chipmc/Particle-Boron-Carrier-v1.0/README.md

View this project on [CADLAB.io](https://cadlab.io/project/1655).

# Particle-Boron-Carrier

This carrier is to support the use of the Boron in outdoor environments.
