chipmc/Particle-Boron-Carrier-v1.0/Carrier Board.csv

Part | Value | Device | Package | Description | HOUSEPART | MANUFACTURER_PART_NUMBER | MFG | MPN | OC_FARNELL | OC_NEWARK | PACKAGE | POPULATE | PROD_ID | SF_ID | SUPPLIER | TOLERANCE | URL | VALUE | VENDOR | VOLTAGE
BORON/ARGON/XENON | PARTICLE-DEVICES-BORON | PARTICLE-DEVICES-BORON | PARTICLE-DEVICES_BORON | Particle Boron Device for Carrier Board Placement
C1 | 0.1uF | CAP0805 | 0805@1 | Capacitor
C2 | 1uF | CAP0805 | 0805@1 | Capacitor
C3 | 0.1uF | CAP0805 | 0805@1 | Capacitor
C4 | 0.1uF | CAP0805 | 0805@1 | Capacitor
C5 | 1uF | CAP0805 | 0805@1 | Capacitor
C8 | 470uF | CAPACITOR_P_10MM | CP10MM | Library: MF_Passives |  |  |  |  |  |  |  | 1
D1 | MF-DIO-SOD123-BAT42 | DIODES_BAT42_SOD-123 | SOD-123 | Library: MF_Discrete_Semiconductor | YES |  |  | MF-DIO-SOD123-BAT42 |  |  |  | 1 |  |  |  |  | https://factory.macrofab.com/part/MF-DIO-SOD123-BAT42 | MF-DIO-SOD123-BAT42
D2 | MF-DIO-SOD123-BAT42 | DIODES_BAT42_SOD-123 | SOD-123 | Library: MF_Discrete_Semiconductor | YES |  |  | MF-DIO-SOD123-BAT42 |  |  |  | 1 |  |  |  |  | https://factory.macrofab.com/part/MF-DIO-SOD123-BAT42 | MF-DIO-SOD123-BAT42
D3 | MF-DIO-SOD123-BAT42 | DIODES_BAT42_SOD-123 | SOD-123 | Library: MF_Discrete_Semiconductor | YES |  |  | MF-DIO-SOD123-BAT42 |  |  |  | 1 |  |  |  |  | https://factory.macrofab.com/part/MF-DIO-SOD123-BAT42 | MF-DIO-SOD123-BAT42
F1 | 1.5A - SLOW BLOW | PPTC_HALF-AMP | 1206 | Resettable Fuse PPTC |  |  |  |  |  |  |  |  | RES-08585 |  |  |  |  | 6V/0.5A
F2 | 500mA - FAST BLOW | PPTC_HALF-AMP | 1206 | Resettable Fuse PPTC |  |  |  |  |  |  |  |  | RES-08585 |  |  |  |  | 6V/0.5A
F3 | 500mA - FAST BLOW | PPTC_HALF-AMP | 1206 | Resettable Fuse PPTC |  |  |  |  |  |  |  |  | RES-08585 |  |  |  |  | 6V/0.5A
FD1 | FIDUCIALUFIDUCIAL | FIDUCIALUFIDUCIAL | FIDUCIAL-MICRO | Fiducial Alignment Points
FD2 | FIDUCIALUFIDUCIAL | FIDUCIALUFIDUCIAL | FIDUCIAL-MICRO | Fiducial Alignment Points
FRAME1 | FRAME-LETTER | FRAME-LETTER | CREATIVE_COMMONS | Schematic Frame - Letter
FRAME2 | FRAME-LETTER | FRAME-LETTER | CREATIVE_COMMONS | Schematic Frame - Letter
FRAME3 | FRAME-LETTER | FRAME-LETTER | CREATIVE_COMMONS | Schematic Frame - Letter
G1 | D5V0L4B5TS | D5V0L4B5TS | SOT-23-5 | 4 CHANNEL LOW CAPACITANCE BI-DIRECTIONAL TVS ARRAY
J1 | H4P-SMD-2.0 | GROVE-CONNECTOR-SMD(4+2P-2.0) | HW4-SMD-2.0 | 320110030 |  |  |  |  |  |  |  |  |  |  |  |  |  | H4P-SMD-2.0
J2 | H4P-SMD-2.0 | GROVE-CONNECTOR-SMD(4+2P-2.0) | HW4-SMD-2.0 | 320110030 |  |  |  |  |  |  |  |  |  |  |  |  |  | H4P-SMD-2.0
J3 |  | CONN_02 | 1X02 | Multi connection point. Often used as Generic Header-pin footprint for 0.1 inch spaced/style header connections
J4 | S2B-PH-SM4-TB(LF)(SN) | JST_2MM_MALE | JST-2-SMD | JST 2MM MALE RA CONNECTOR |  |  | S2B-PH-SM4-TB(LF)(SN) |  |  |  |  |  | CONN-11443 | PRT-08612
J5 | S2B-PH-SM4-TB(LF)(SN) | JST_2MM_MALE | JST-2-SMD | JST 2MM MALE RA CONNECTOR |  |  | S2B-PH-SM4-TB(LF)(SN) |  |  |  |  |  | CONN-11443 | PRT-08612
JP1 |  | M06LOCK | 1X06_LOCK | Header 6
JP2 |  | M06LOCK | 1X06_LOCK | Header 6
JP3 | STAND-OFF | STAND-OFF | STAND-OFF | Stand Off
JP4 | STAND-OFF | STAND-OFF | STAND-OFF | Stand Off
JP5 | STAND-OFF | STAND-OFF | STAND-OFF | Stand Off
JP6 | STAND-OFF | STAND-OFF | STAND-OFF | Stand Off
JP7 | JUMPER-SMT_3_1-NC_TRACE_SILK | JUMPER-SMT_3_1-NC_TRACE_SILK | SMT-JUMPER_3_1-NC_TRACE_SILK | Normally closed trace jumper (1 of 2 connections)
JP9 | JUMPER-SMT_2_NC_PASTE_SILK | JUMPER-SMT_2_NC_PASTE_SILK | SMT-JUMPER_2_NC_PASTE_SILK | Normally closed solder jumper
Q1 | MMBT2222A | TRANS_NPN-MMBT2222AL | SOT23-3 | NPN transistor |  |  |  |  |  |  |  |  | TRANS-08049 |  |  |  |  | 600mA/40V
R1 | 270k | RESISTOR0805-RES | 0805 | Resistor
R2 | 270k | RESISTOR0805-RES | 0805 | Resistor
R3 | 100k | RESISTOR0805-RES | 0805 | Resistor
R4 | 100k | RESISTOR0805-RES | 0805 | Resistor
R5 | 10k | RESISTOR0805-RES | 0805 | Resistor
R6 | 4.7k | RESISTOR0805-RES | 0805 | Resistor
R7 | 4.7k | RESISTOR0805-RES | 0805 | Resistor
R10 | 10k | RESISTOR0805-RES | 0805 | Resistor
R11 | 100k | RESISTOR0805-RES | 0805 | Resistor
R12 | 100 | RESISTOR0805-RES | 0805 | Resistor
R13 | 100k | RESISTOR0805-RES | 0805 | Resistor
R14 | 100k | RESISTOR0805-RES | 0805 | Resistor
S2 | B3F-4000 | 40-XX-ROUND | B3F-40XX-ROUND | OMRON SWITCH
SW2 | MF-SW-TACT-6MM | TACT_6MM | TACT6MM | Library: MF_Switches | YES |  |  | MF-SW-TACT-6MM |  |  |  | 1 |  |  |  |  | https://factory.macrofab.com/part/MF-SW-TACT-6MM | MF-SW-TACT-6MM
U1 | TMP36GRTZ | TMP36GRTZ-REEL7 | RJ_5 |  |  | TMP36GRTZREEL7 |  |  |  |  |  |  |  |  |  |  |  |  | Analog Devices Inc
U2 | TPL5010 | TPL5010 | TSOT-23 | This is a TI Ultra-Low-Power External watchdog.
U3 | MB85RC64 | MB85RC128PNF-G-JNE1 | SOIC127P600X175-8N | Memory FRAM |  |  |  | MB85RC128PNF-G-JNE1 | 1831995 | 93R5161 | SO-8 |  |  |  | FUJITSU
U7 | NAND | 4093DT | MC14093B-TSSOP14 | Quad 2-input NAND schmitt trigger
V1 | VC080505C150DP | VARISTOR | 0805
V2 | VC080505C150DP | VARISTOR | 0805
V3 | VC080505C150DP | VARISTOR | 0805
