chipmc/Particle-Boron-Carrier-v1.0/Carrier Board.brd

## EAGLE design Carrier Board.brd (2019-04-28)

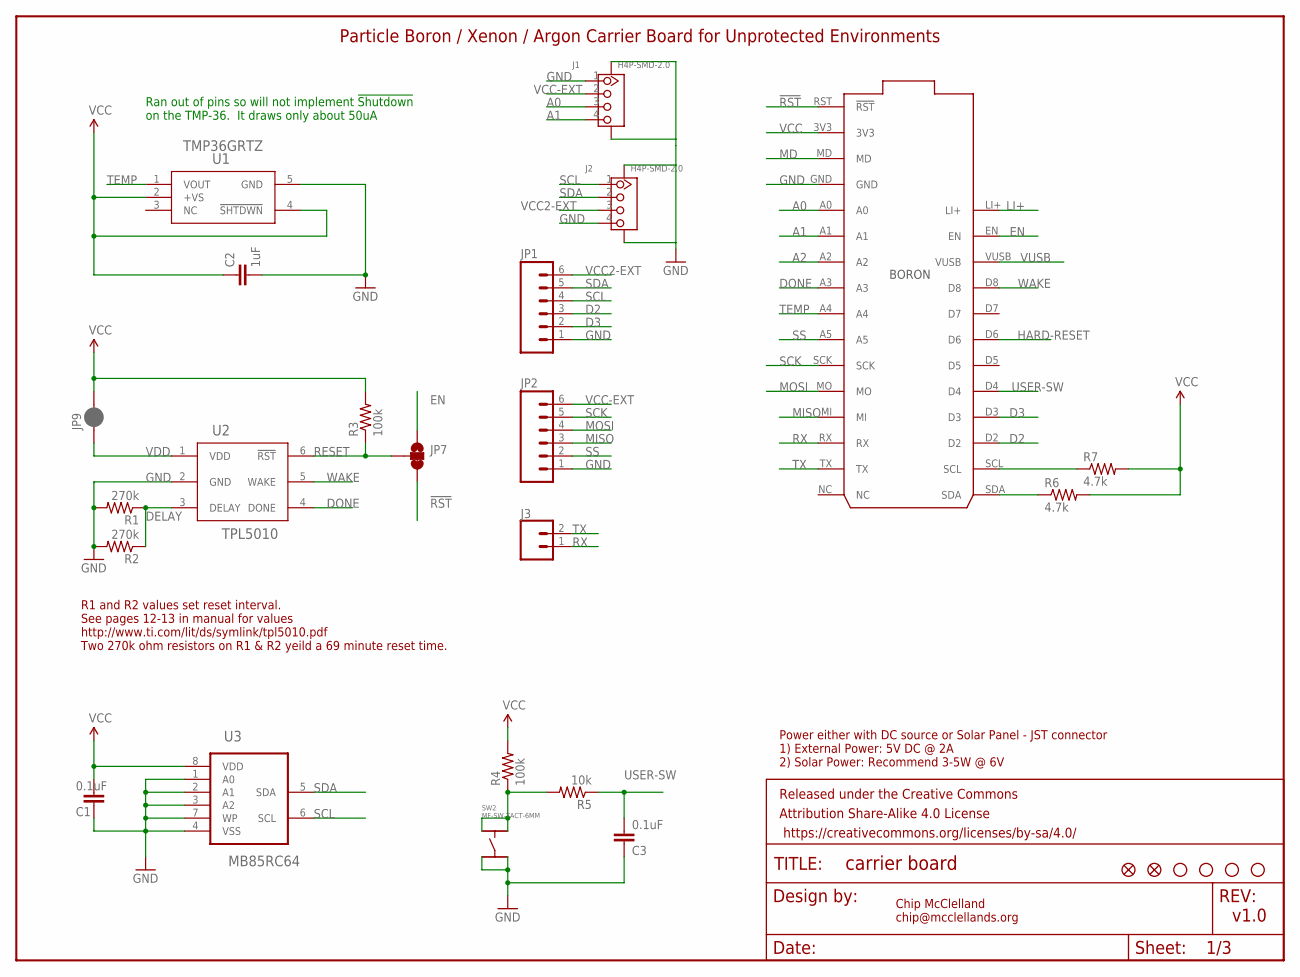
[picture p1: schematic Carrier Board.sch, sheet 1, Sensors]

Parts:
BORON/ARGON/XENON: PARTICLE-DEVICES-BORON; PARTICLE-DEVICES_BORON
C1, C3: 0.1uF; 0805@1
C2: 1uF; 0805@1
FD1, FD2: FIDUCIALUFIDUCIAL; FIDUCIAL-MICRO
FRAME1: FRAME-LETTER; CREATIVE_COMMONS
J1, J2: H4P-SMD-2.0; HW4-SMD-2.0
J3: CONN_02; 1X02
JP1, JP2: M06LOCK; 1X06_LOCK
JP3, JP4, JP5, JP6: STAND-OFF
JP7: JUMPER-SMT_3_1-NC_TRACE_SILK; SMT-JUMPER_3_1-NC_TRACE_SILK
JP9: JUMPER-SMT_2_NC_PASTE_SILK; SMT-JUMPER_2_NC_PASTE_SILK
R1, R2: 270k; 0805
R3, R4: 100k; 0805
R5: 10k; 0805
R6, R7: 4.7k; 0805
SW2: MF-SW-TACT-6MM; TACT6MM
U1: TMP36GRTZ; RJ_5
U2: TPL5010; TSOT-23
U3: MB85RC64; SOIC127P600X175-8N

Connections:
!RST: BORON/ARGON/XENON.RST (!RST), JP7.3
A0: BORON/ARGON/XENON.A0, J1.3
A1: BORON/ARGON/XENON.A1, J1.4
A2: BORON/ARGON/XENON.A2
D2: BORON/ARGON/XENON.D2, JP1.3; also elsewhere on the board
D3: BORON/ARGON/XENON.D3, JP1.2; also elsewhere on the board
DELAY: R1.1, R2.1, U2.3 (DELAY)
DONE: BORON/ARGON/XENON.A3, U2.4 (DONE)
EN: BORON/ARGON/XENON.EN, JP7.1; also elsewhere on the board
GND: BORON/ARGON/XENON.GND, C1.2, C2.2, C3.2, J1.1, J1.SS1, J1.SS2, J2.4, J2.SS1, J2.SS2, JP1.1, JP2.1, R1.2, R2.2, SW2.P$3, SW2.P$4, U1.5 (GND), U2.2 (GND), U3.1 (A0), U3.2 (A1), U3.3 (A2), U3.4 (VSS), U3.7 (WP); also elsewhere on the board
HARD-RESET: BORON/ARGON/XENON.D6; also elsewhere on the board
LI+: BORON/ARGON/XENON.LI+; also elsewhere on the board
MD: BORON/ARGON/XENON.MD
MISO: BORON/ARGON/XENON.MI, JP2.3
MOSI: BORON/ARGON/XENON.MO, JP2.4
unnamed: R4.1, R5.2, SW2.P$1, SW2.P$2
RESET: JP7.2, R3.1, U2.6 (!RST)
RX: BORON/ARGON/XENON.RX, J3.1
SCK: BORON/ARGON/XENON.SCK, JP2.5
SCL: BORON/ARGON/XENON.SCL, J2.1, JP1.4, R7.1, U3.6 (SCL); also elsewhere on the board
SDA: BORON/ARGON/XENON.SDA, J2.2, JP1.5, R6.1, U3.5 (SDA); also elsewhere on the board
SS: BORON/ARGON/XENON.A5, JP2.2
TEMP: BORON/ARGON/XENON.A4, U1.1 (VOUT)
TX: BORON/ARGON/XENON.TX, J3.2
USER-SW: BORON/ARGON/XENON.D4, C3.1, R5.1
VCC: BORON/ARGON/XENON.3V3, C1.1, C2.1, JP9.2, R3.2, R4.2, R6.2, R7.2, U1.2 (+VS), U1.4 (!SHTDWN), U3.8 (VDD); also elsewhere on the board
VCC2-EXT: J2.3, JP1.6; also elsewhere on the board
VCC-EXT: J1.2, JP2.6; also elsewhere on the board
VDD: JP9.1, U2.1 (VDD)
VUSB: BORON/ARGON/XENON.VUSB; also elsewhere on the board
WAKE: BORON/ARGON/XENON.D8, U2.5 (WAKE)

Notes on the sheet:
Chip McClelland chip@mcclellands.org
v1.0
Power either with DC source or Solar Panel - JST connector 1) External Power: 5V DC @ 2A 2) Solar Power: Recommend 3-5W @ 6V
Particle Boron / Xenon / Argon Carrier Board for Unprotected Environments
R1 and R2 values set reset interval. See pages 12-13 in manual for values http://www.ti.com/lit/ds/symlink/tpl5010.pdf Two 270k ohm resistors on R1 & R2 yeild a 69 minute reset time.
Ran out of pins so will not implement !Shutdown on the TMP-36. It draws only about 50uA

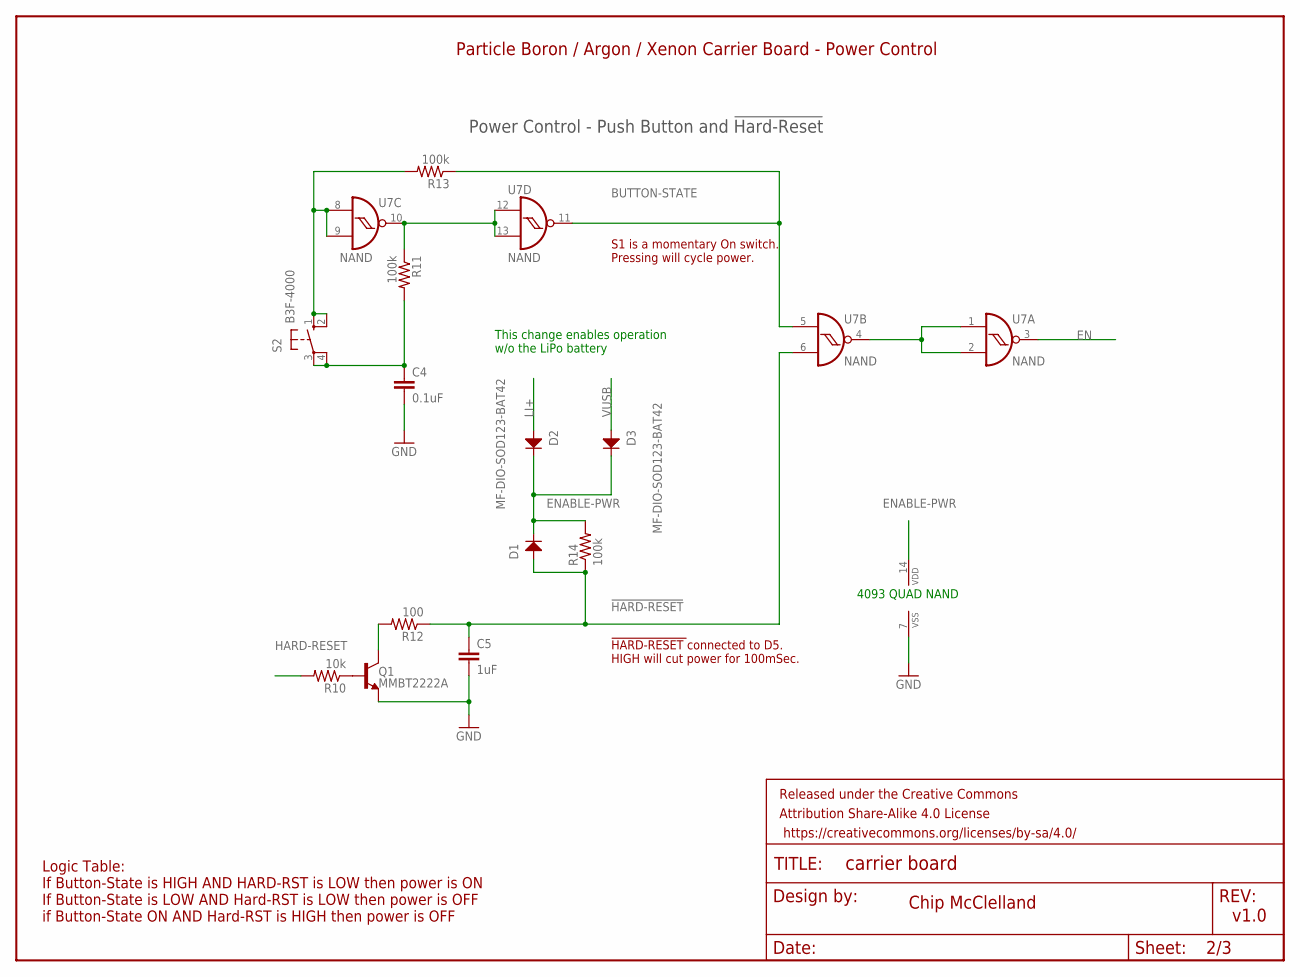
[picture p2: schematic Carrier Board.sch, sheet 2, Power Control]

Parts:
C4: 0.1uF; 0805@1
C5: 1uF; 0805@1
D1, D2, D3: MF-DIO-SOD123-BAT42; SOD-123
FRAME2: FRAME-LETTER; CREATIVE_COMMONS
Q1: MMBT2222A; SOT23-3
R10: 10k; 0805
R11, R13, R14: 100k; 0805
R12: 100; 0805
S2: B3F-4000; B3F-40XX-ROUND
U7: NAND; MC14093B-TSSOP14

Connections:
!HARD-RESET: C5.1, D1.ANODE, R12.1, R14.1, U7.6 (I1)
BUTTON-STATE: R13.1, U7.5 (I0), U7.11 (O)
EN: U7.3 (O); also elsewhere on the board
ENABLE-PWR: D1.CATHODE, D2.CATHODE, D3.CATHODE, R14.2, U7.14 (VDD)
GND: C4.2, C5.2, Q1.2 (E), U7.7 (VSS); also elsewhere on the board
HARD-RESET: R10.2; also elsewhere on the board
LI+: D2.ANODE; also elsewhere on the board
unnamed: U7.1 (I0), U7.2 (I1), U7.4 (O)
unnamed: R11.1, U7.10 (O), U7.12 (I0), U7.13 (I1)
unnamed: Q1.1 (B), R10.1
unnamed: Q1.3 (C), R12.2
unnamed: C4.1, R11.2, S2.3, S2.4 (P1)
unnamed: R13.2, S2.1 (S), S2.2 (S1), U7.8 (I0), U7.9 (I1)
VUSB: D3.ANODE; also elsewhere on the board

Notes on the sheet:
Particle Boron / Argon / Xenon Carrier Board - Power Control
4093 QUAD NAND
Power Control - Push Button and !Hard-Reset
Chip McClelland
v1.0
Logic Table: If Button-State is HIGH AND HARD-RST is LOW then power is ON If Button-State is LOW AND Hard-RST is LOW then power is OFF if Button-State ON AND Hard-RST is HIGH then power is OFF
!HARD-RESET !connected to D5. HIGH will cut power for 100mSec.
S1 is a momentary On switch. Pressing will cycle power.
This change enables operation w/o the LiPo battery

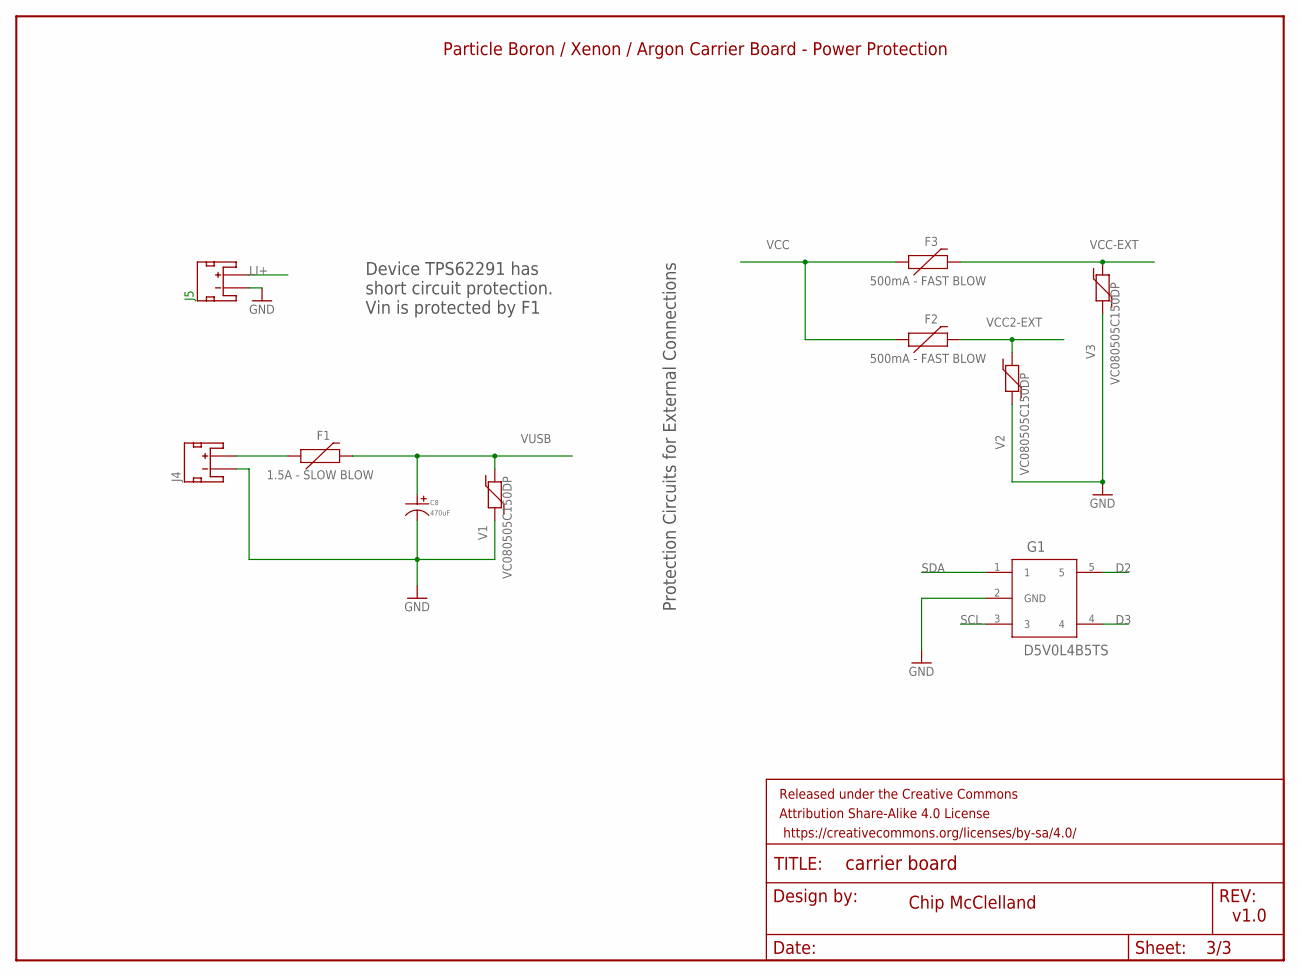
[picture p3: schematic Carrier Board.sch, sheet 3, Protection and 5V Boost]

Parts:
C8: 470uF; CP10MM
F1: 1.5A - SLOW BLOW; 1206
F2, F3: 500mA - FAST BLOW; 1206
FRAME3: FRAME-LETTER; CREATIVE_COMMONS
G1: D5V0L4B5TS; SOT-23-5
J4, J5: S2B-PH-SM4-TB(LF)(SN); JST-2-SMD
V1, V2, V3: VC080505C150DP; 0805

Connections:
D2: G1.5; also elsewhere on the board
D3: G1.4; also elsewhere on the board
DC-IN-EXT: F1.1, J4.2 (+)
GND: C8.P$2, G1.2 (GND), J4.1 (-), J5.1 (-), V1.1, V2.1, V3.1; also elsewhere on the board
LI+: J5.2 (+); also elsewhere on the board
SCL: G1.3; also elsewhere on the board
SDA: G1.1; also elsewhere on the board
VCC: F2.1, F3.1; also elsewhere on the board
VCC2-EXT: F2.2, V2.2; also elsewhere on the board
VCC-EXT: F3.2, V3.2; also elsewhere on the board
VUSB: C8.P$1, F1.2, V1.2; also elsewhere on the board

Notes on the sheet:
Protection Circuits for External Connections
Device TPS62291 has short circuit protection. Vin is protected by F1
Chip McClelland
v1.0
Particle Boron / Xenon / Argon Carrier Board - Power Protection

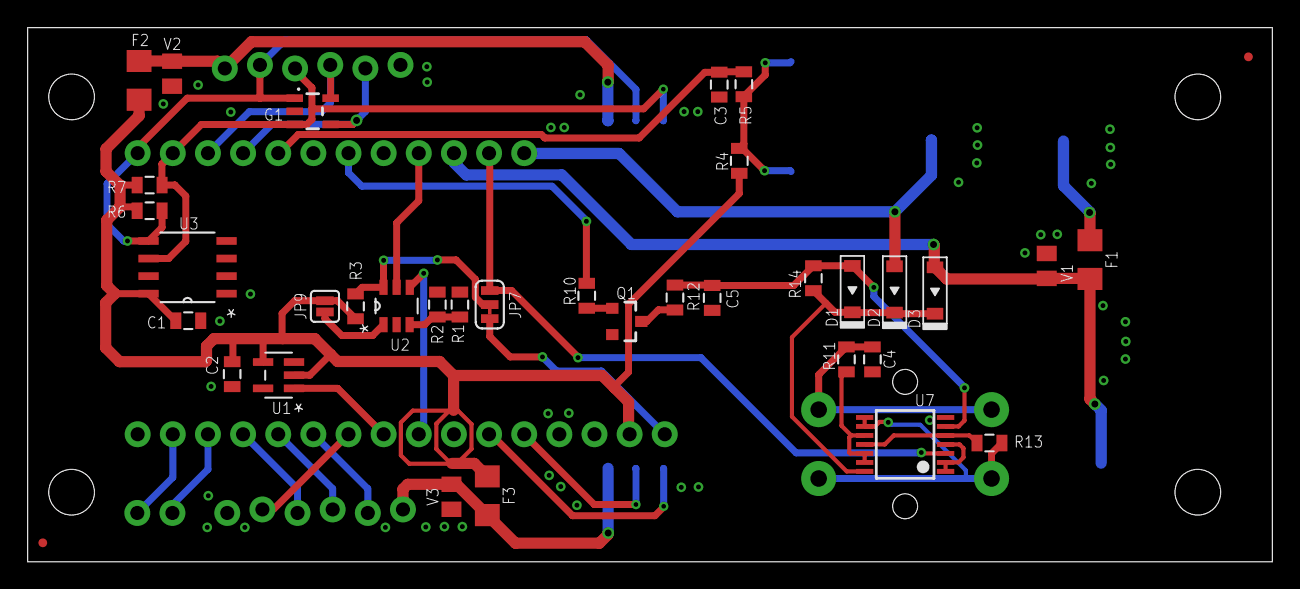
[picture p4: board Carrier Board.brd from above]

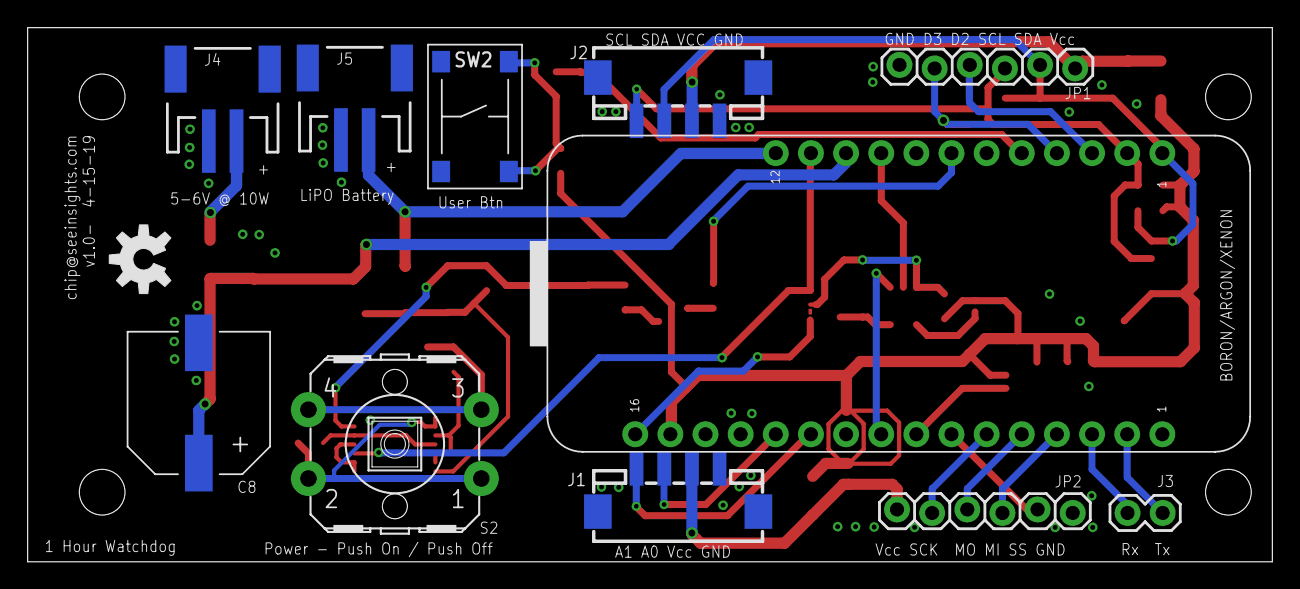
[picture p5: board Carrier Board.brd from below]

Board: 2 copper layers, 90.0 x 38.6 mm, 55 parts (12 on the bottom side), 39 nets.

Other parts of the board:
U$2: OSHW-LOGO-M
