chipmc/Particle-Boron-Carrier-v1.0/(commit log)

2019-03-28 v0.1 - First rough layout
    Just getting started.
    [Carrier Board.brd, Carrier Board.sch]
2019-03-28 v0.1a - updated readme
    [Carrier Board.brd]
2019-03-28 v0.11 - Refining placments
    [Carrier Board.brd, Carrier Board.sch]
2019-03-28 More tweaks
    D8 for wake, no shutdown on TMP-36 and Hard-reset connected. Power protection for off-board VCC
    [Carrier Board.brd, Carrier Board.sch]
2019-03-29 Added Heratch's v3 starter
    [Carrier Board.brd, Carrier Board.sch]
2019-03-29 First Pass - Ready to send to OSHPark
    [Carrier Board.brd, Carrier Board.sch]
2019-03-29 Labelling and less traces under the chips
    [Carrier Board.brd, Carrier Board.sch]
2019-03-30 Got ride of traces under components
    [Carrier Board.brd]
2019-04-13 Added 2-Grove Connectors
    [Carrier Board.brd, Carrier Board.sch]
2019-04-15 v1.0 - sent to OSHPark today.
    [Carrier Board.brd, Carrier Board.sch]
2019-04-15 v1.0 - minor tweaks post sending to OSHPark
    [Carrier Board.brd]
2019-04-28 Had to move the Done pin to A3
    [Carrier Board.brd, Carrier Board.sch]
2019-04-28 Create Carrier Board.csv
    [Carrier Board.csv]
